HansonHe-UW/ece198-smart-dumbbell/data/README.md

# Data handling

No participant recordings are included.

Raw recordings and session logs are ignored by Git by default. Use anonymous test identifiers, avoid medical histories and identifying video, and keep any participant-to-ID mapping outside this repository. Confirm permission and course requirements before recording volunteers.

A public sample dataset must be deliberately reviewed, appropriately authorized and documented before inclusion. Synthetic samples must be clearly labelled synthetic. An ignored file is not access-controlled or encrypted.
