HansonHe-UW/ece198-smart-dumbbell/HANDOFF.md

# HANDOFF — 给组员和组员的 AI 助手

状态日期：2026-11-03（晚）。这份文件是给"刚接手这个项目的人或 AI"看的现状快照。把它整段贴给你的 AI（Claude、ChatGPT、Copilot 等）作为开场上下文，然后再让它读下面"先读哪些文件"里的内容。文件会过时，以 `docs/decisions.md` 的日期记录为准；发现矛盾时相信日期更新的那条。

## 1. 项目一句话

UWaterloo ECE 198 Group 57（Hanson He、Eric Zhu、Zoe Wang、Julia Zhang）为 CCCARE 居家康复做一个**智能哑铃**：手柄里的惯性传感器 + 微控制器上的机器学习识别二头弯举并计数，手柄上的光学传感器在运动中测心率，OLED 本地显示，Wi-Fi 把数据发到电脑记录。版本 1 只做一个动作（bicep curl），三个类别 `curl` / `idle` / `other`。最终演示日期记为 2026-11-25（来自组员口头说法，未对照 LEARN 核实）。

分工（2026-11-03 定）：

| 方向 | 负责人 |
|---|---|
| 动作分类（ML 线 1） | Hanson He |
| 计数与板上集成（ML 线 2） | Julia Zhang |
| 上位机记录（issue #2） | Julia Zhang |
| 硬件：电子、电源、接线、心率模块 | Zoe Wang |
| 外壳 CAD 与打印 | Eric Zhu |

心率算法（FR-07、FR-08）还没有人认领。

## 2. 现在到底有什么、没有什么

**有：**
- 完整的需求规格（中英文）、验收目标 AT-01 到 AT-10、决策记录、硬件与预算表、团队 Git 流程说明。
- 概念 CAD v0.1（DWG + 生成脚本）和一张 AI 渲染图。
- 第一版 pitch deck 和讲稿（内容仍写着旧方案 ADXL335，是交付过的快照，不要悄悄改）。
- v1 原理图（`schematic-v1.svg`，2026-11-04 按实物重画）、接线图和接线表（`hardware/wiring/`）。I2C 部分已在面包板上验证；按钮、LED、蜂鸣器还没接。
- 到货的 Nano ESP32、Adafruit 4517、两根 4209 线，借到的 GY-MAX30102，套件 OLED；已买的充电宝。
- `ml/workplan.md`：动作分类和计数两条线的分工、接口草案、录数据计划和到 11-24 的时间表（2026-11-03 组内同意）。`ml/data-protocol.md` v0.1 录数据协议。
- `ml/train/` 训练流程（切窗、31 个特征、按人划分评估、导出 C 头文件）在合成数据上跑通；`firmware/classifier/` 板上分类器编译通过、主机侧自检与 Python 一致到 1e-6，**还没在板子上跑过**，头文件是合成数据训出来的。
- `software/data_logger.py`：上位机记录器原型（Julia，2026-11-06，PR #4）。轮询 HTTP `/status`、终端显示、追加 CSV，处理重复/乱序、断线/重连、无效心率置空。配套 `mock_server.py` 和 3 个单测。**只在 mock 上跑过**，`/status`、`/target` 接口是提案，固件侧还没有，待 Role ④ 确认。
- `firmware/bringup/` 里 7 个测试 sketch 和中文步骤说明；`tests/results/` 里 2026-11-03 的 6 条真实测试记录：烧录、Wi-Fi 热点、I2C 扫描、IMU 104 Hz 出数和轴向、心率模块、OLED。

**没有：**
- 完整的应用固件。`firmware/app/` 是整合草稿（2026-11-06，单按钮、IMU+分类器+占位计数器+心率+OLED，无 Wi-Fi），已上板：四个模块扫到、IMU 104 Hz 无丢样、按钮可用；弯举计数、LED、手指心率未测（`tests/results/2026-11-06_app-v0-first-run.md`）。上位机记录器只对 mock 服务器验证过。
- 任何验收测试（AT-01 到 AT-10）的结果。所有性能数字仍是**提议的目标**。
- 可靠的心率数值：模块能出信号，但 2026-11-03 静止测试里算出的 bpm 比手表高 9 到 14（见第 6 节）。
- 尺寸测量、充电宝自动关机测试、Grove 套件清单核对。

## 3. 硬件基线（已定，不要重新讨论）

| 角色 | 零件 | 来源 | 状态 |
|---|---|---|---|
| 主控 | Arduino Nano ESP32（ABX00083，ESP32-S3，3.3 V 逻辑，Wi-Fi） | DigiKey，CAD 28.66 | 已到货，排针已焊，烧录／Wi-Fi 通过 |
| 运动传感器 | Adafruit 4517（LSM6DSOX 加速度+陀螺仪 + LIS3MDL 磁力计） | DigiKey，CAD 29.63 | 已到货，104 Hz 出数、轴向核对通过。v1 只用 LSM6DSOX |
| IMU 连接线 | Adafruit 4209 STEMMA QT 转杜邦公头，150 mm ×2 | DigiKey | 已到货，一根在用一根备用 |
| 心率 | GY-MAX30102 模块 | 学校借用 | 已借到，0x57 可见，手指检测正常，bpm 算法待换 |
| 显示 | OLED，SSD1306 128×64，I2C 0x3C | 课程基础套件 | 已核对，显示正常 |
| 按钮 ×3 | 开始 / 暂停继续 / 结束 | 课程基础套件 | |
| 提示 | Grove 蜂鸣器（振动马达若套件有） | Grove Starter Kit 借用 | 2026-11-02 照片里托盘有蜂鸣器和 LED 座，没看到振动马达 |
| 电源 | INIU SnapGo P81 充电宝，5000 mAh，自带 USB-C 线，80×38×29 mm，115 g | amazon.ca，CAD 29.69 税前 | 已买 |
| 外壳 | 自制中空哑铃壳，内置配重 | 3D 打印（UW RPC E5-2002 自助，约 CAD 0.08/g） | 未开始 |

学校还有一块 **Dragino Yún Shield v1.1**（带 Wi-Fi 的 UNO 扩展板）和 **UNO R4 Minima**。两者都**不进最终哑铃**：R4 的 32 kB SRAM 跑不了模型加 Wi-Fi，Yún 功耗和体积都不合适。R4 只做桌面调试。

**预算：** 已花 CAD 119.55（DigiKey 86.00 含税运 + 充电宝 33.55），原上限 100 已超。组内 2026-11-01 口头同意加预算，**新上限还没定**。外壳打印加五金估 60–80，整项目大约 180–200。

## 4. 已经定了的事（有日期记录，改之前先读 decisions.md）

- 2026-10-18：选智能哑铃概念；一个动作三个类别；v1 包含片上 ML、计数、显示、Wi-Fi、运动中心率。
- 2026-10-31：IMU 从借用的 ADXL335 改为购买的 LSM6DSOX；主控定为 Nano ESP32；R4 + 外接 Wi-Fi 方案否决。
- 2026-10-31 晚：实际下单的是 9 轴 4517 而不是推荐的 6 轴 4438，决定不退换。
- 2026-11-01：电源定为 INIU P81 充电宝，不用裸锂电池。
- 2026-11-02：接线 v1 草图和引脚提议入库（`hardware/wiring/`）。
- 2026-11-03：板子到货当天完成 bring-up。四个 I2C 设备（0x1C、0x3C、0x57、0x6A）同挂一条总线无冲突；IMU 轴向与丝印一致；MAX30102 的 1.8 V 上拉没有挡住通信。
- 2026-11-03：ML 拆成"动作分类"和"计数与板上集成"两条线各自负责（Hanson He、Julia Zhang），中间只有一个接口约定；录音匿名化后提交到 `data/sessions/`。详见 `ml/workplan.md`。

## 5. 还没定的事（需要人拍板，AI 不要替团队决定）

1. **FR-07 / AT-04 / AT-05 运动中心率标准。** 弯举约 1 Hz，和心率频带重叠，手握光学传感器在运动中大概率达不到"覆盖率 ≥ 90%、MAE ≤ 10 bpm"。2026-11-03 的静止测试已经给出数据：手指专门放上去、不动，脉搏幅度只有直流的 0.1% 到 0.4%，简单算法算出的 bpm 比手表高 9 到 14。运动中只会更差。备选：改为"信号质量允许时给出运动中读数，组间静止保证输出"。要在测试方法冻结前决定。
2. **新的预算上限。** 建议 200，未确认。
3. **外壳尺寸和布局。** CAD v0.1 存在于仓库里，但 Hanson 的意见是不把它当约束，由负责建模的人重新开始；这个意见还没写进 decisions.md。约束条件：充电宝腔体至少 86×44×35 mm，板子和充电宝大概率只能放在一侧头部，配重用钢垫圈串在螺杆上，目标 1–1.5 kg。
4. **借到的 Grove 套件到底有哪些模块**，决定提示用蜂鸣器还是振动马达。
5. 心率参考设备借什么（AT-04 要同步对比）。

## 6. 已知的坑

- **GY-MAX30102 的 I2C 上拉常接在板上 1.8 V 轨。** 实测和 4517、OLED 同挂一条总线时通信正常，但高电平还没用万用表量过。
- **不要在 Nano ESP32 的串口上切换 DTR/RTS。** 会把板子送进 ROM 下载模式，上传报 exit status 74。解法见 `firmware/bringup/README.md` 第 2 步。
- **SparkFun MAX3010x 的 checkForBeat 不够用。** 要换成带通加找峰或频谱法，并按 FR-08 输出有效标志。
- **充电宝低负载自动关机。** 哑铃整机电流可能只有几十到一百多毫安，有的充电宝会判定空载断电。到货后先连续跑 10 分钟验证。
- **Nano ESP32 是 3.3 V 逻辑。** 套件里的 LED 选红或黄，220 Ω；绿蓝白在 3.3 V 下太暗。
- **Nano 插不进 Grove Base Shield。** 要 Grove 转杜邦线（Seeed 110990210）或剪一根 Grove 线。
- **Pitch deck、讲稿、规格 PDF 导出、CAD 里的传感器占位尺寸**都还写着 ADXL335 或旧尺寸，是快照，等有新版本再整体替换，不要零碎改。
- **AI 代写比例高。** 仓库里的文档大部分是 Hanson 和 AI 一起写的，格式整齐不等于经过验证。看到"预计"、"proposed"、"not yet verified" 就当作没验证。

## 7. 仓库导航：先读哪些文件

按权威性排序，冲突时前者优先：

1. `docs/decisions.md` — 决策日志和未决问题，带日期。
2. `docs/hardware.md` — 零件、价格、接口注意事项、到货检查项。
3. `docs/specification.md` / `docs/specification-zh.md` — 需求 FR-01…13 和验收 AT-01…10。两个语言版本要同步改。
4. `hardware/wiring/README.md` + `schematic-v1.svg`（原理图，由 `gen_schematic.py` 生成）+ `wiring-v1.svg` — 引脚分配和网络表。
5. `README.md` — 概览和里程碑勾选。
6. `docs/team-guide.md` + `CONTRIBUTING.md` — Git 流程（中文）。
7. `AGENTS.md` — 给 AI 代理的规则，和本文件互补。

快照类（只读，不单独修改）：`presentation/`、`hardware/cad/`、`hardware/renders/`、`docs/exports/`。

仓库外还有一个 `Hardware Datasheets/` 文件夹在 Hanson 电脑上（Nano ESP32、R4 Minima、SSD1306、LSM6DSOX 手册），不在 Git 里。

## 8. 到货后的核对清单

- 量 Nano ESP32 和 4517 的实际外形尺寸，更新 `docs/hardware.md` 和外壳输入。
- 看 GY-MAX30102 板上有没有 1.8 V / 3.3 V 上拉选择焊盘；记录 INT 是否引出。
- 确认 OLED 四个脚顺序（GND-VCC-SCL-SDA 还是 VCC-GND-SCL-SDA）和地址（0x3C / 0x3D）。
- 充电宝：量自带线长度；带 Wi-Fi 和 OLED 跑 10 分钟看会不会自动关机。
- 跑一个 I2C 扫描 sketch，确认 0x6A、0x57、0x3C 都在。
- 把实际引脚写进 `firmware/`，并回填 `hardware/wiring/README.md`。

## 9. 各条线的入口（给要开工的人）

| 方向 | 负责人 | 第一步 | 产出放哪 |
|---|---|---|---|
| 固件 | Zoe Wang（传感器读数）/ 两条 ML 线（分类、计数） | 三个独立读数 sketch：IMU 100 Hz 串口输出、MAX30102 原始红外、OLED 显示 | `firmware/` |
| 动作分类 | Hanson He | 协议和流程已有，下一步是定 IMU 安装方向、录前 3 人，然后 `train.py` 出第一版 | `ml/`、`firmware/classifier/`，匿名录音放 `data/sessions/` |
| 计数与板上集成 | Julia Zhang | 按 `ml/workplan.md` 第 3 节：用录好的 CSV 离线调计数器，不等模型；再加门控和状态机上板 | `firmware/counter/`、`ml/tools/`、`tests/results/` |
| 上位机 | Julia Zhang | 电脑端接收 Wi-Fi 数据、实时显示、导出 CSV 和会话摘要（FR-11、FR-12） | `software/` |
| 外壳 | Eric Zhu | 从充电宝腔体和单侧头部布局开始建模，壁厚 2–3 mm，2026-11-10 前出第一版打印件 | `hardware/cad/`，新版本用新文件名 |
| 心率可行性 | Zoe Wang | 借参考设备，做 AT-04 的 60 秒同步对比，先于冻结测试方法 | `tests/`，用 `tests/templates/test-record.md` |

## 10. 给 AI 的工作规则（摘要，完整版在 AGENTS.md）

- 不要悄悄换硬件、加动作、删功能、改验收数字。要改就写成提议，并在 `docs/decisions.md` 加带日期的记录。
- 改需求时中英文规格一起改；改不了的导出件标记"需重新生成"。
- 区分软件检查、仿真、传感器实测、机械检查、临床说法。没测的写"未测"。
- 价格、库存、尺寸要带日期和来源。
- 不要提交任何含地址、电话、卡号的订单文件，不要提交可识别参与者的原始录音。
- Git：组员用分支 + PR；commit 信息用英文祈使句，正文写清改了什么和为什么。Hanson 在组会审过的文档改动会直接推 main。
- 不要覆盖别人的 CAD 或 PPT，用新版本文件名。
