HansonHe-UW/ece198-smart-dumbbell/(list of files, cad)

Other CAD files:
hardware/cad/Smart_Dumbbell_Concept_v01.dwg
