HansonHe-UW/ece198-smart-dumbbell/tests/results/2026-11-03_bringup-05-max30102.md

# Bring-up 05: GY-MAX30102 at rest, finger on the sensor

## Identification

- Date: 2026-11-03 (evening)
- Tester: Hanson He (finger, Apple Watch reading); upload and capture run by Claude
- Related issue: none
- Requirement / acceptance-test ID: precondition for FR-07 / FR-08; informal rest-only check, NOT AT-04/AT-05
- Commit SHA: sketch `firmware/bringup/05_max30102` as committed with this record
- Firmware and library versions: Arduino ESP32 Boards 2.0.18-arduino.5, SparkFun MAX3010x 1.1.2
- Hardware/module versions and mounting: borrowed GY-MAX30102 plugged into the course breadboard, sharing the I2C bus with the Adafruit 4517 (3 devices: 0x1C, 0x57, 0x6A). Nano 3V3 supply. LED current ~6 mA (0x1F), 411 µs pulse, 4096 nA range, red+IR.
- Test level: physical hardware
- Status: Run

## Objective and predefined acceptance criterion

From `firmware/bringup/README.md` step 5: part ID 0x15; IR < 20000 without a finger and > 50000 with one; after 20 s the on-board `bpm_avg` within ±5 of a reference; finger removal clears the reading within 2 s.

## Setup and procedure

1. `03_i2c_scan` first: 0x57 appears alongside 0x1C and 0x6A.
2. Capture A: 5 s without a finger.
3. Capture B: 60 s at 25 Hz effective (100 sps, average 4), finger resting on the window.
4. Capture C: 70 s at 100 Hz effective (400 sps, average 4) after changing the sketch; finger placed about 20 s in.
5. Reference: Apple Watch heart-rate screen on the other wrist (values reported by Hanson; see below).

## Observations and measurements

- No finger: IR 515 to 550 counts, `finger=0`, bpm 0. Pass.
- Finger on: IR 50 000 to 125 000, `finger=1` immediately. Pass.
- Capture B (25 Hz): finger on 100 % of 60 s, DC about 115 000, pulsatile AC only 0.13 to 0.30 % of DC. On-board detector flagged 7 beats in 60 s; `bpm_avg` 26 to 47, wrong. Offline 15 s windows: spectrum 38/54/88/50 bpm, peak counting 72/60/88/92 bpm.
- Capture C (100 Hz): finger on 67 % of 70 s (placed late). On-board detector flagged 28 beats, median interval 95 bpm during the steady part; `bpm_avg` still swung 63 to 148 within 10 s windows. Offline on the steadiest window (30-45 s): AC/DC 0.35 %, peak counting about 100 bpm.
- Reference (Apple Watch, read by Hanson during the captures): about 86 bpm. So capture B's on-board value (26 to 47) was wrong by a factor of two or more; capture C's steady-segment median (95) and the offline peak count (about 100) were 9 to 14 bpm high. Neither meets the ±5 bpm criterion.

## Result and limitations

- Outcome: Inconclusive. Sensor, wiring, I2C address and finger detection pass. Heart-rate value does not yet meet the ±5 bpm criterion.
- Evidence: captures summarised above; raw CSV kept outside the repository.
- Known limitations and causes identified:
  1. Pulsatile amplitude 0.1 to 0.4 % of DC is low (typical fingertip PPG 0.5 to 2 %). Finger pressure and placement dominate; no mechanical guide yet.
  2. SparkFun `checkForBeat()` expects ~100 Hz; at 25 Hz it missed most beats. Fixed in the sketch; at 100 Hz it still produces unstable intervals on this weak signal.
  3. The 4-beat running average in the sketch is too short to reject single bad intervals.
  4. Bus high level with the module's 1.8 V pull-ups was not measured; detection worked, so it is not blocking, but still measure it.
- Follow-up task: (b) replace the beat detector with a band-passed (0.7-3 Hz) peak picker or spectral estimate over a 8-10 s window and report validity as FR-08 requires; (c) design the grip window so the finger pad rests on the sensor with controlled light pressure; (d) only then plan AT-04 with a synchronized reference. The rest-only result above says nothing about heart rate during curls.
