HansonHe-UW/ece198-smart-dumbbell/hardware/wiring/SCH_Smart Dumbbell_2026-11-08.pdf

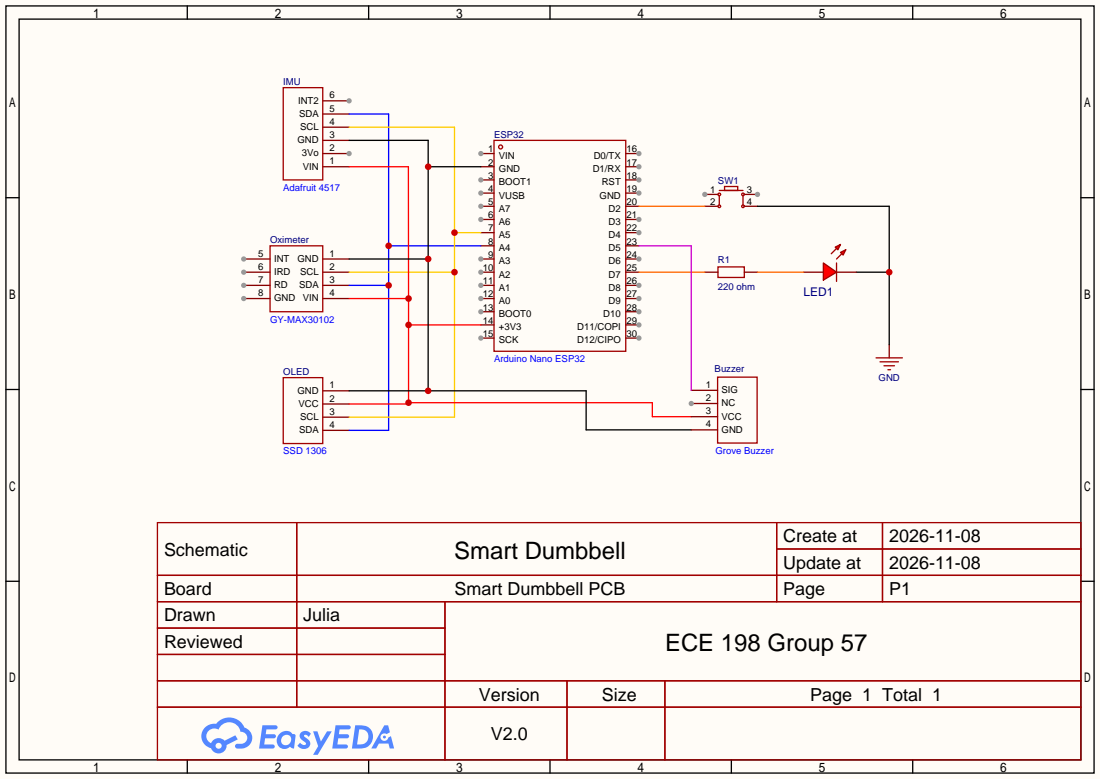
[picture p2: page 1]

Schematic | Smart Dumbbell | Create at | 2026-11-08

Update at | 2026-11-08

Board | Smart Dumbbell PCB | Page | P1
Drawn | Julia | ECE 198 Group 57
Reviewed

Version | Size | Page 1 Total 1
V2.0
