HansonHe-UW/ece198-smart-dumbbell/(commit log)

2026-11-01 docs: revise hardware baseline to Nano ESP32 + LSM6DSOX IMU and record DigiKey order
    Replace the borrowed ADXL335 with a purchased Adafruit LSM6DSOX-based IMU
    so repetition counting can use angular rate. Record the 2026-10-31 DigiKey
    order as placed: Nano ESP32 (ABX00083), Adafruit 4517 9-DoF board (kept
    instead of the recommended 4438; magnetometer unused in v1), two 4209
    STEMMA QT cables, FedEx shipping. Invoiced total CAD 86.00.
    - hardware.md: rewritten with invoiced prices, borrowed/kit parts,
    alternatives considered, I2C address map, MAX30102 1.8 V pull-up
    warning, and the remaining CAD 14 for power and enclosure.
    - decisions.md: baseline updated; dated decision log entries; open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
2026-11-01 docs: record INIU P81 power bank purchase and updated spend
    Power supply selected and bought on 2026-11-01: INIU SnapGo P81, 5000 mAh,
    built-in USB-C cable, CAD 29.69 before tax. Total spend is now CAD 119.55,
    over the original CAD 100 ceiling; a new ceiling is still to be agreed.
    Adds arrival checks (low-load shut-off, cable length, enclosure openings)
    and the cavity size the enclosure must provide.
2026-11-02 Add v1 wiring diagram and net list (draft before parts arrive)
    - hardware/wiring/wiring-v1.svg: Nano ESP32 with one shared 3.3 V I2C bus
    (4517 via 4209 cable, GY-MAX30102, kit OLED), three kit pushbuttons on
    D2-D4 with INPUT_PULLUP, Grove buzzer/vibration/LED on D5-D7, power bank
    on USB-C only
    - hardware/wiring/README.md: net list, expected I2C addresses, pull-up
    note for the MAX30102 1.8 V rail, and the items that can only be
    settled on arrival (OLED pin order, pull-up pads, Grove cable adapters)
    - Link the page from README.md and docs/hardware.md
2026-11-03 Add Nano ESP32 bring-up sketches and test procedure
    Four sketches, one check each: blink (board alive), Wi-Fi AP (radio),
    I2C scan (bus and 4517 present), IMU CSV stream at 104 Hz (sensor data,
    also the recording format). Plus a pyserial recorder and a Chinese
    step-by-step guide with pass criteria and recovery steps.
    All four compile for arduino:esp32:nano_nora (core 2.0.18-arduino.5);
    Chirale_TensorFlowLite hello_world also compiles. Nothing has run on the
    board yet.
2026-11-03 Record bring-up 01 (blink) result on the Nano ESP32
    Upload over DFU and serial output verified on 2026-11-03; LED colours not
    yet checked by eye.
2026-11-03 tests: blink LED colours confirmed visually
2026-11-03 Bring-up 02: add serial heartbeat to the AP sketch, record first run
    The AP sketch now prints SSID, IP and station count every 2 s so the
    test does not depend on catching the boot message. Firmware reports the
    AP up at 192.168.4.1; no client has joined yet, so the record is
    inconclusive. README documents the DTR/RTS download-mode pitfall and
    the esptool watchdog-reset recovery.
2026-11-03 tests: bring-up 03 (I2C scan) and 04 (IMU stream) passed
    4517 answers at 0x6A and 0x1C; LSM6DSOX streams 6 axes at 104.0 Hz with
    9-10 ms spacing, |a| = 9.82 m/s^2 at rest, accel noise ~0.012 m/s^2.
    README milestone added.
2026-11-03 tests: IMU axis and sign check added to bring-up 04 record
2026-11-03 tests: 4517 silkscreen axes match the measured frame
2026-11-03 Add 05_max30102 bring-up sketch (raw IR/red stream with beat detector)
    SparkFun MAX3010x library; shares the I2C bus with the 4517. Guide step 5
    gives wiring, pass criteria and the pull-up caveat. Compiles; not yet run.
2026-11-03 Add 06_imu_hr_combined: IMU 104 Hz and MAX30102 25 Hz on one bus, non-blocking
    Prints per-5-second scheduling statistics (IMU rate, max gap, late ticks,
    HR rate, worst loop time) as first evidence towards FR-13 / AT-07.
    Compiles; not yet run.
2026-11-03 Bring-up 05: MAX30102 runs on the shared bus; heart-rate value not yet reliable
    Sketch now reads through the FIFO at 100 Hz effective (400 sps / avg 4),
    which SparkFun's beat detector expects. Record: finger detection and
    signal path pass; pulsatile amplitude 0.1-0.4 % of DC and the simple
    detector give unstable bpm. Follow-ups listed in the record.
2026-11-03 Add 07_oled_buttons usability sketch; record watch reference for 05
    Mock UI: three buttons (start/pause, rep, end), SSD1306 big-digit count,
    LED and buzzer feedback, debounced events on serial. Compiles; not run.
    Heart-rate record now carries the Apple Watch reference (~86 bpm).
2026-11-03 tests: bring-up 07 OLED display passes on the 4-device bus
2026-11-04 docs: split motion ML work into classification and counting lines
    Add ml/workplan.md with the two-owner split agreed on 2026-11-03:
    movement classification (FR-03/04, AT-01) and repetition counting with
    on-device integration (FR-02/05/06, AT-02/03), each with its own files,
    branch, issue and documentation. The only shared contract is the
    classifier output (t_ms,label,conf once per second over a 2 s window),
    kept as a draft until confirmed in the first week.
    Add data/sessions/ for anonymised recordings so the second owner can
    work offline with one board. Record the decision in decisions.md and
    point HANDOFF, README and ml/README at the plan. Owner names, IMU
    mounting orientation and curl_par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
2026-11-04 docs: record task owners for ML lines, hardware and enclosure
    Classification: Hanson He. Counting and on-device integration: Julia
    Zhang. Hardware (electronics, power, wiring, heart-rate module): Zoe
    Wang. Enclosure CAD and printing: Eric Zhu. Computer logger stays with
    Julia Zhang (issue #2). Heart-rate algorithm has no owner yet.
    Add an owner table to HANDOFF section 1 and an owner column to the
    section 9 entry table; fill the owner row in ml/workplan.md and the
    decision entry.
2026-11-04 ml: recording protocol, training pipeline and on-device classifier skeleton
    Classification line (Hanson He) deliverables that need no hardware:
    - ml/data-protocol.md v0.1: labels, per-participant recording list,
    file naming, recording steps, quality checks. Mounting orientation
    is still open and must be fixed before the first recording.
    - ml/train/: CSV loading, 2 s / 1 s windowing, 31 hand features,
    leave-one-participant-out evaluation, logreg or MLP, export to a C
    header plus a self-test header. check_recording.py validates one
    file; make_synthetic.py produces clearly labelled synthetic sessions
    for exercising the pipeline.
    - firmware/classifier/: plain C++ features + dense in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
2026-11-04 hardware: schematic v1 drawn from the modules in hand
    Adds hardware/wiring/schematic-v1.svg and its generator gen_schematic.py.
    Nets match the 2026-11-03 bench build for the I2C part (4517, GY-MAX30102,
    kit OLED on A4/A5); buttons D2-D4, buzzer D5 and LED D7 follow
    07_oled_buttons and are still untested. Records what the photos settled:
    OLED pin order GND-VCC-SCL-SDA, MAX30102 INT broken out, Seeed Grove
    buzzer, no vibration motor.
2026-11-06 docs: HANDOFF records the computer logger prototype (PR #4)
2026-11-06 firmware: integrated app v0 with one button, classifier, counter stub, heart rate, OLED
    Compiles for nano_nora (Flash 10 %, RAM 12 %); not yet run on the board.
    Short press start/pause/resume, long press end. COUNT_GATE and USE_BUZZER
    off by default; classifier headers are copies of firmware/classifier/.
2026-11-06 firmware/app: chunked OLED transfer, keep I2C at 400 kHz; first on-board run recorded
    Measured on the board (S line, 250 ms display refresh): Adafruit's display()
    pushed the 1 KB frame in one 32 ms burst, so every refresh made 3 IMU samples
    late and read back as duplicates (imu_late +57 per 5 s, imu_dt_max 33 ms).
    The frame is now sent 64 bytes per loop, only when the next IMU tick is at
    least 3 ms away, and draw() does not start a new frame while one is in flight.
    Adafruit_SSD1306's default clkAfter (100 kHz) was applied after every display
    transaction, so the whole shared bus ran at 100 kHz with the OLED present
    (Wire.getClock() = 100000, a 64-byte chunk took 6 ms). The constructor now
    pa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
2026-11-08 docs(hardware): add schematic v2 draft
2026-11-08 docs: research rationale for 1 kg smart dumbbell prototype
